cottonhouse/LEVORGIdleStopESP32/IMG_3749.jpg

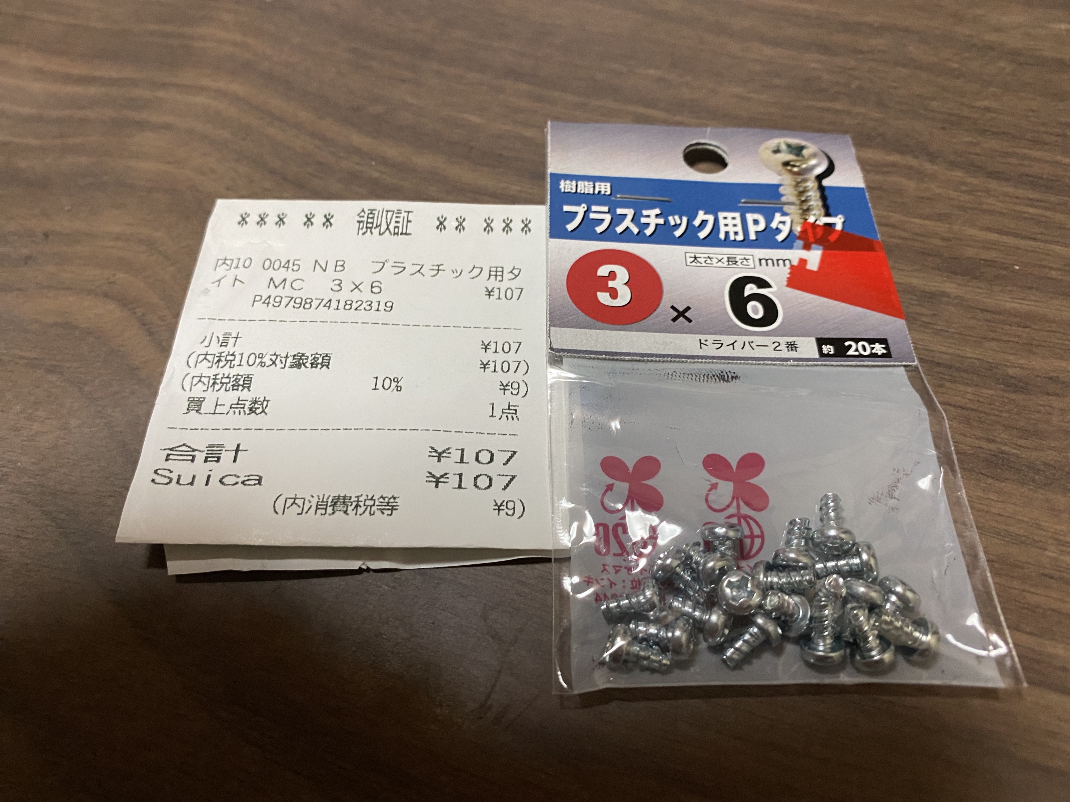
IMG_3749.jpg
