cottonhouse/LEVORGIdleStopESP32/IMG_3826_2.jpeg

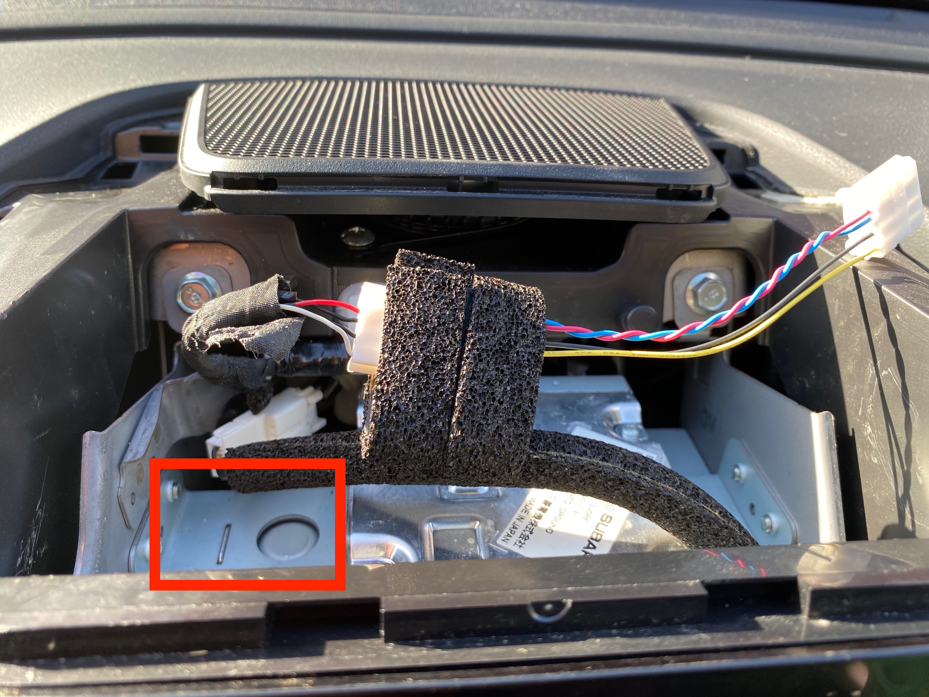
IMG_3826_2.jpeg
