cottonhouse/LEVORGIdleStopESP32/Board01.jpeg

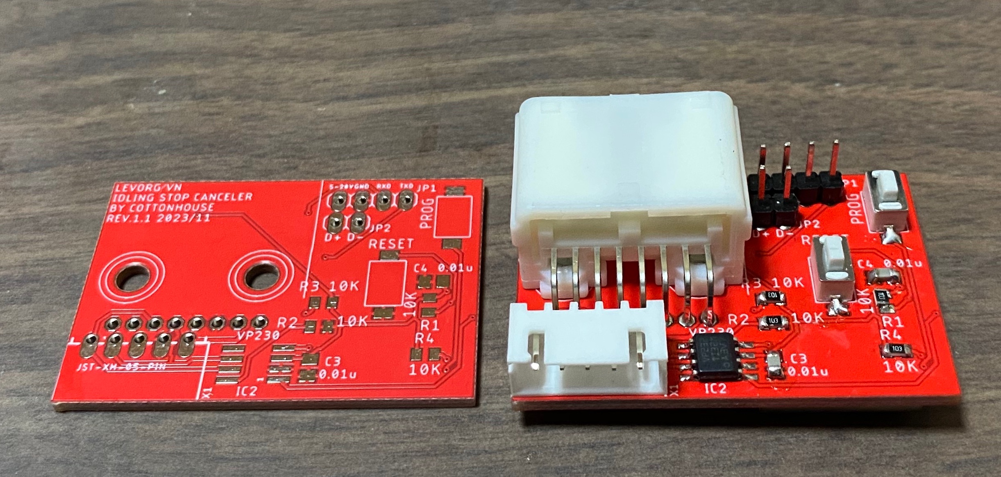
Board01.jpeg
