cottonhouse/LEVORGIdleStopESP32/Board02.jpeg

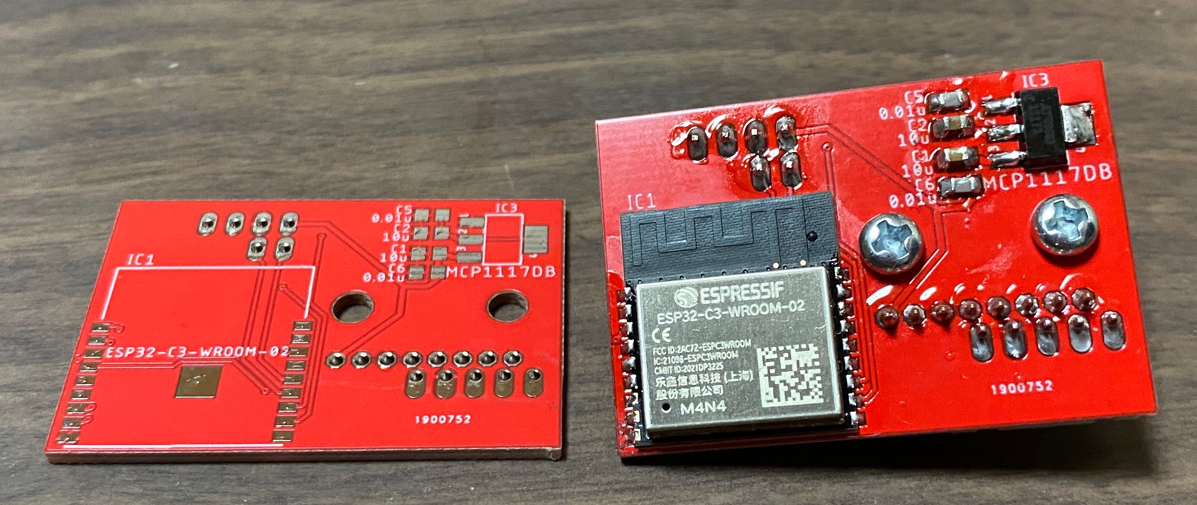
Board02.jpeg
