cottonhouse/LEVORGIdleStopESP32/SCHEMANTIC.png

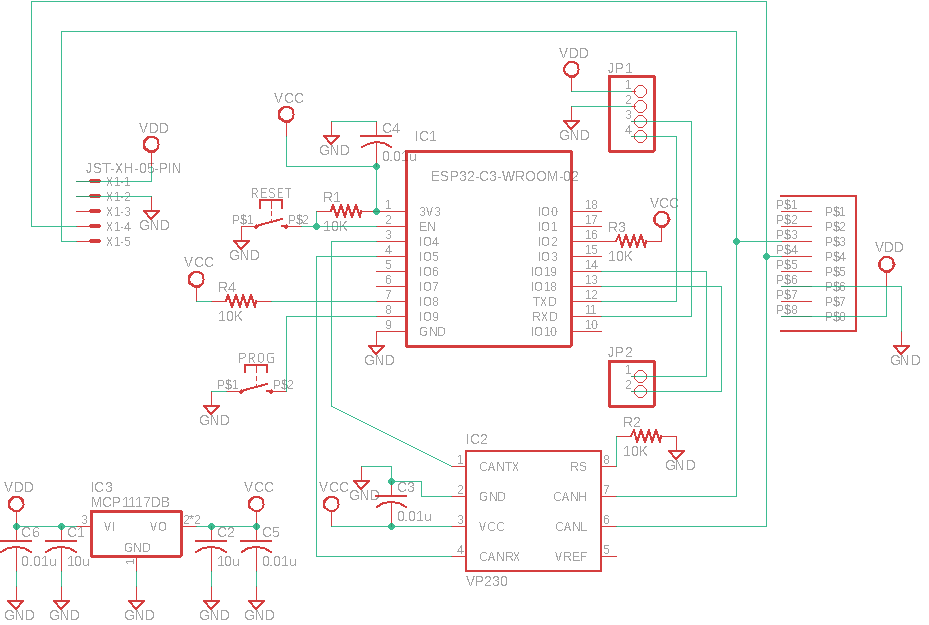
SCHEMANTIC.png
